bigcrimping/bhangmeterV3/assets/block-diagram-dark.png

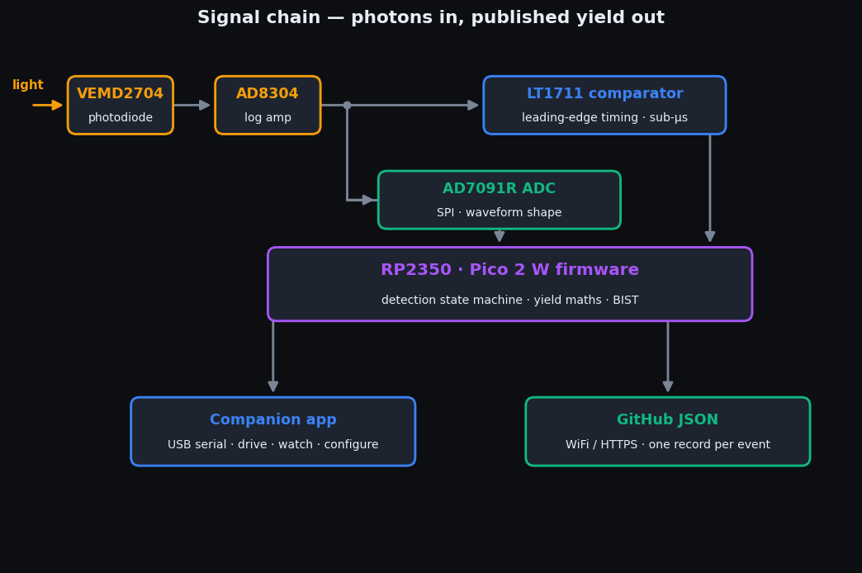
assets/block-diagram-dark.png
