bigcrimping/bhangmeterV3/assets/carrier-dark.png

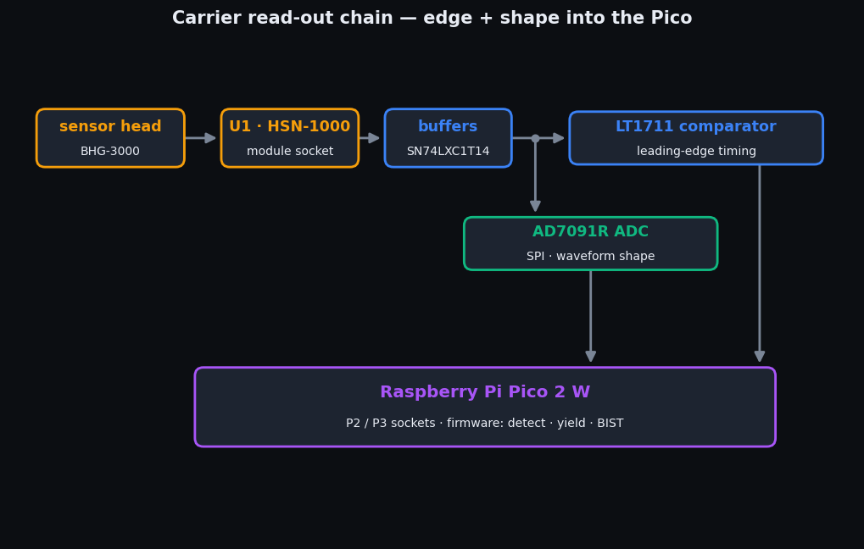
assets/carrier-dark.png
