bigcrimping/bhangmeterV3/assets/code-dataflow-dark.png

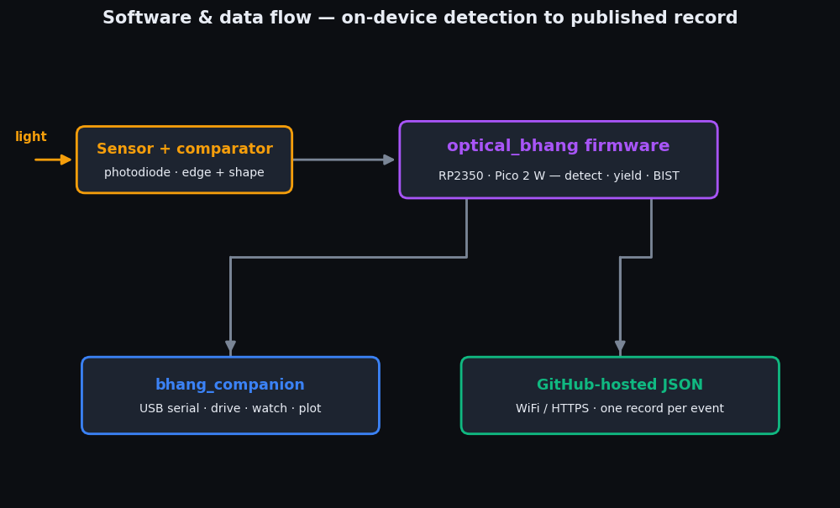
assets/code-dataflow-dark.png
