bigcrimping/bhangmeterV3/assets/double-pulse-annotated-dark.png

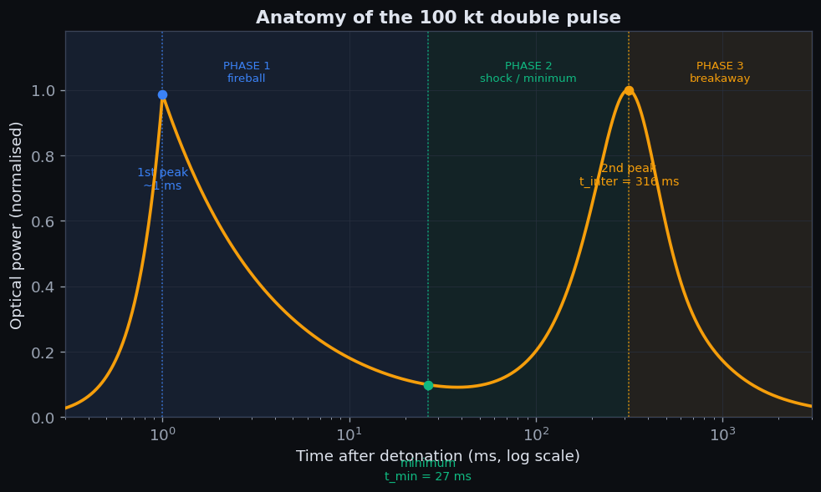
assets/double-pulse-annotated-dark.png
