bigcrimping/bhangmeterV3/assets/double-pulse-literature-dark.png

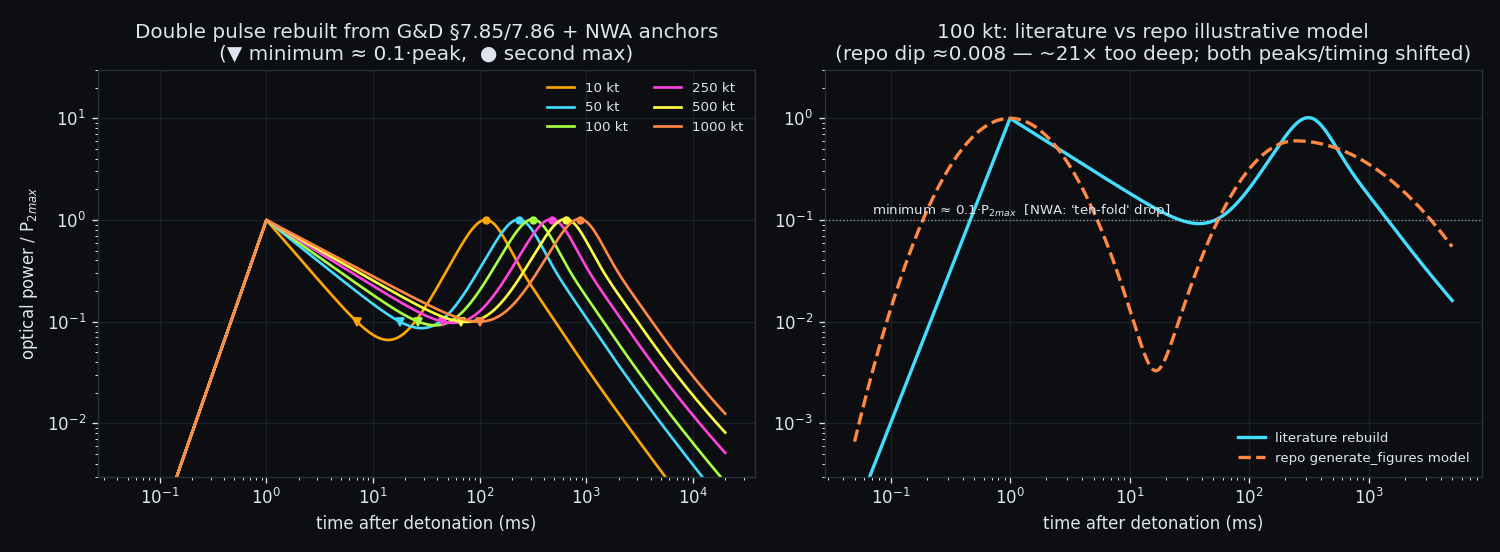
assets/double-pulse-literature-dark.png
