bigcrimping/bhangmeterV3/assets/double-pulse-literature-light.png

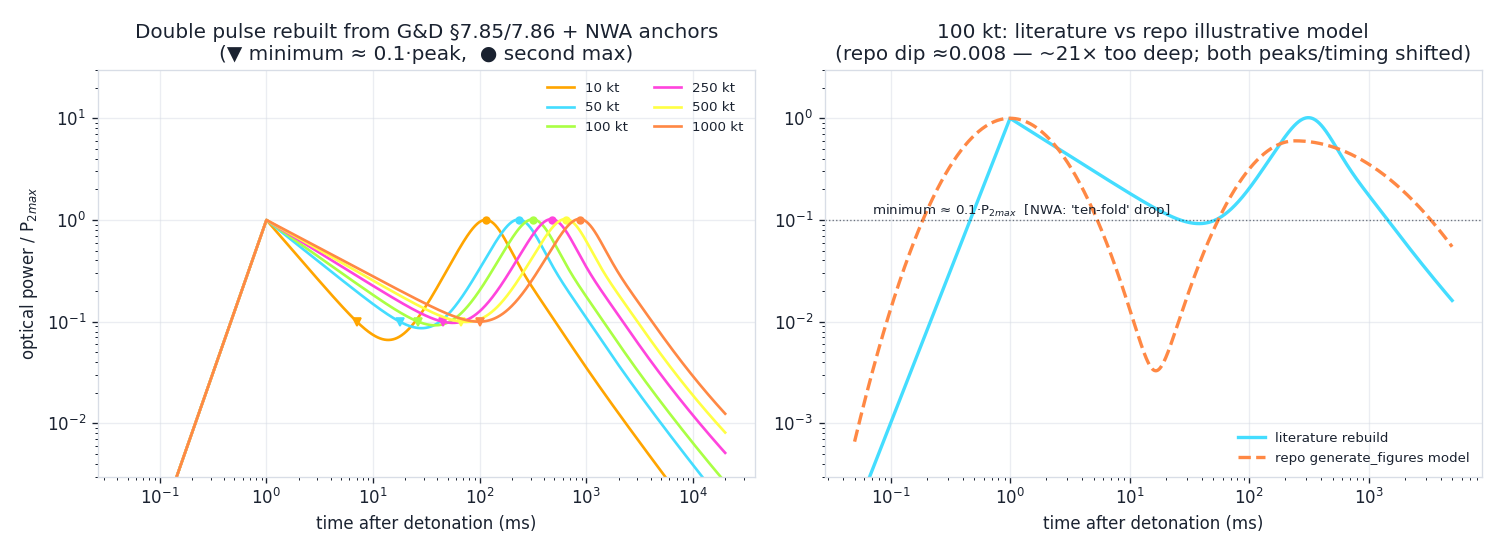
assets/double-pulse-literature-light.png
