bigcrimping/bhangmeterV3/assets/double-pulse-overlay-dark.png

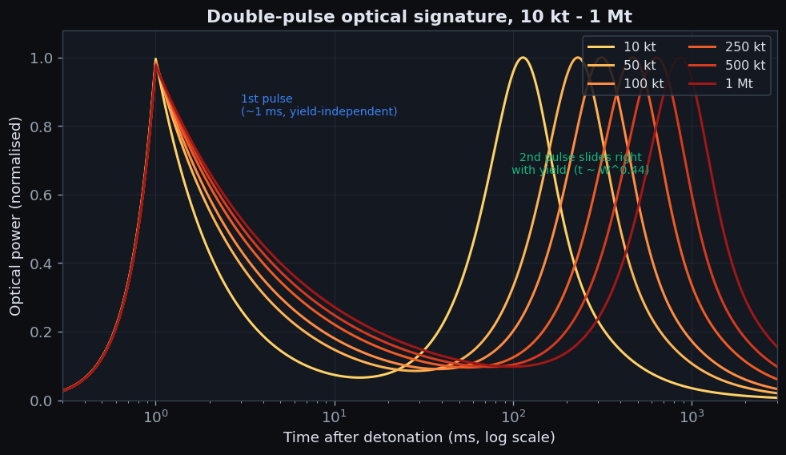
assets/double-pulse-overlay-dark.png
