bigcrimping/bhangmeterV3/assets/module.jpg

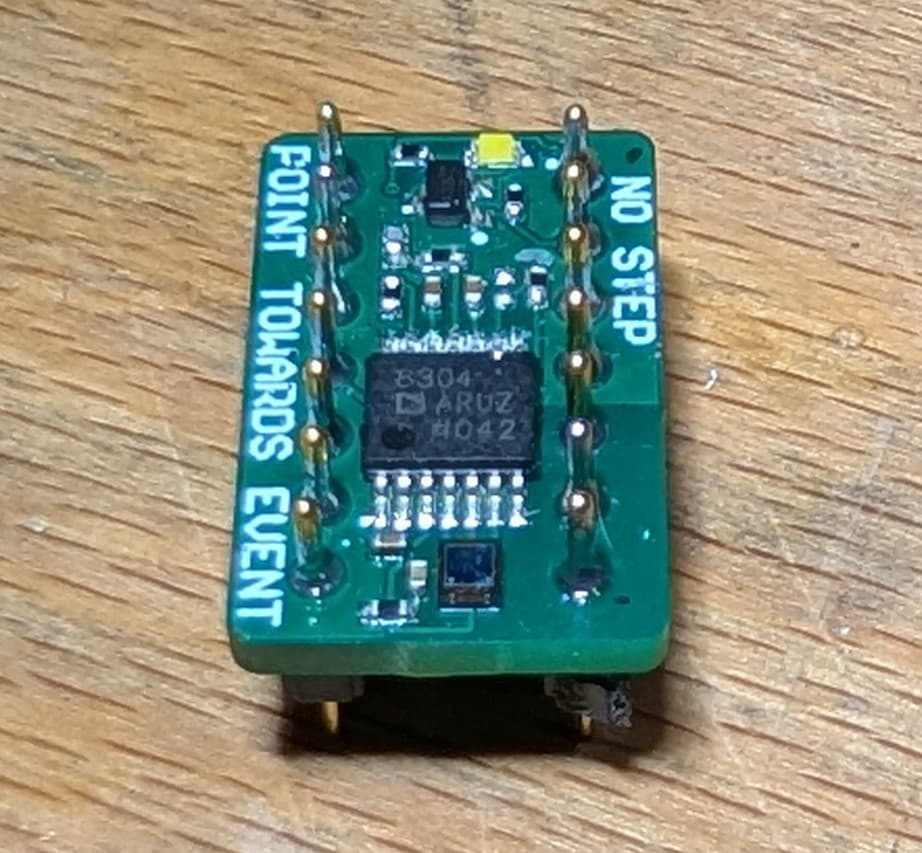
assets/module.jpg
