bigcrimping/bhangmeterV3/assets/pcb-boards-dark.png

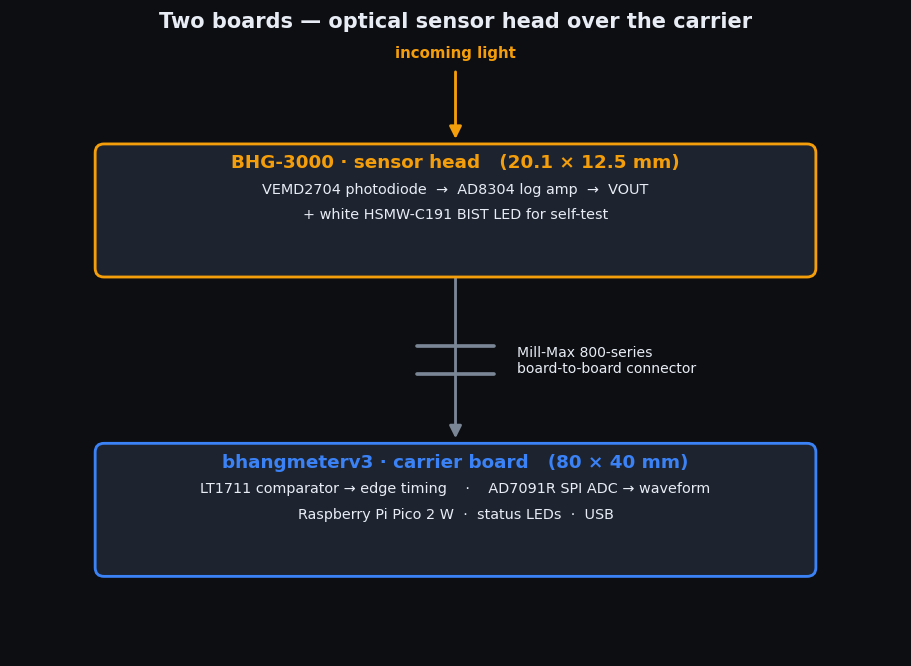
assets/pcb-boards-dark.png
