bigcrimping/bhangmeterV3/assets/photocurrent-vs-yield-dark.png

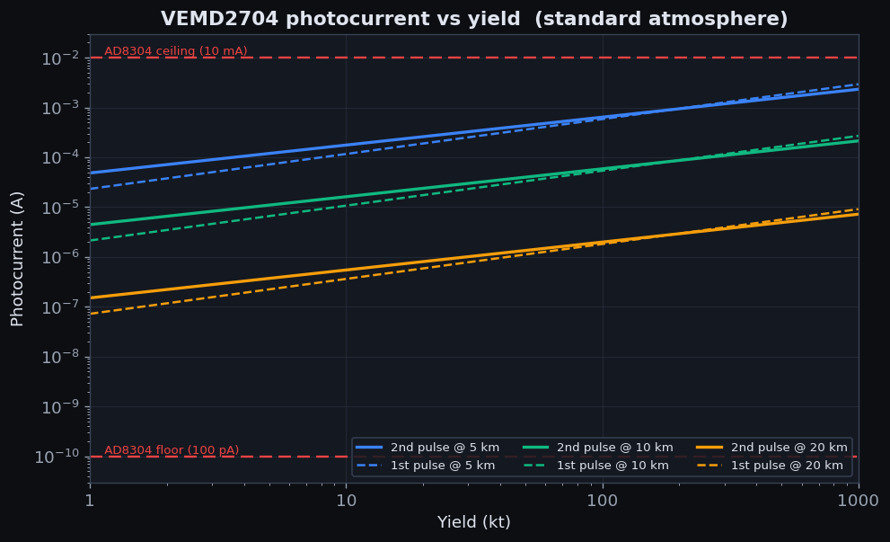
assets/photocurrent-vs-yield-dark.png
