bigcrimping/bhangmeterV3/assets/sensorhead-dark.png

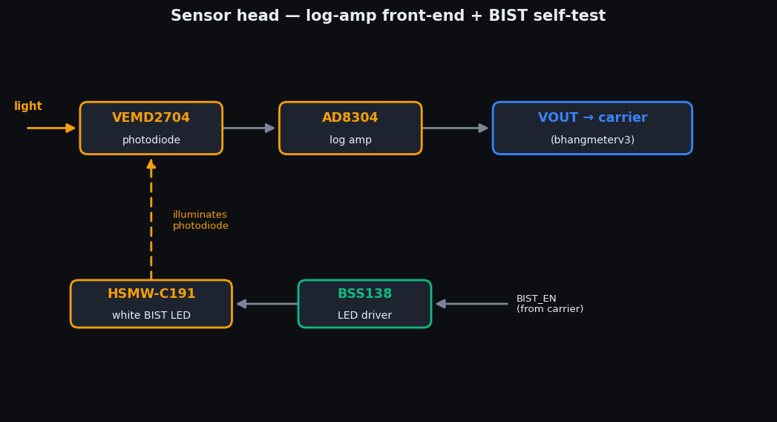
assets/sensorhead-dark.png
