bigcrimping/bhangmeterV3/assets/timing-vs-yield-dark.png

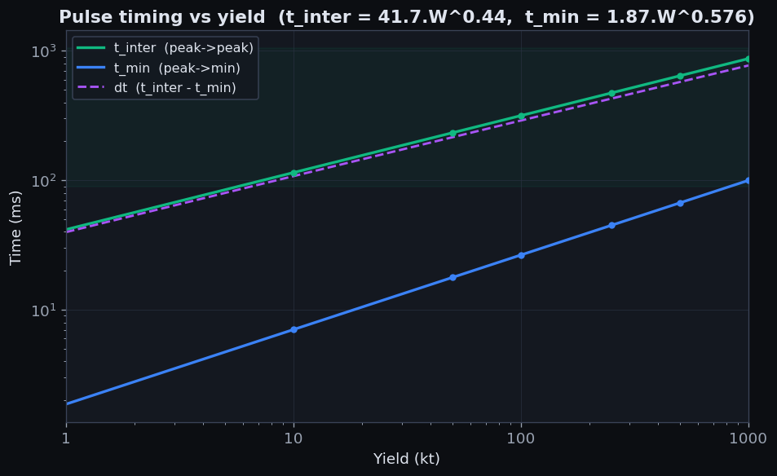
assets/timing-vs-yield-dark.png
