bigcrimping/bhangmeterV3/assets/timing-vs-yield-literature-dark.png

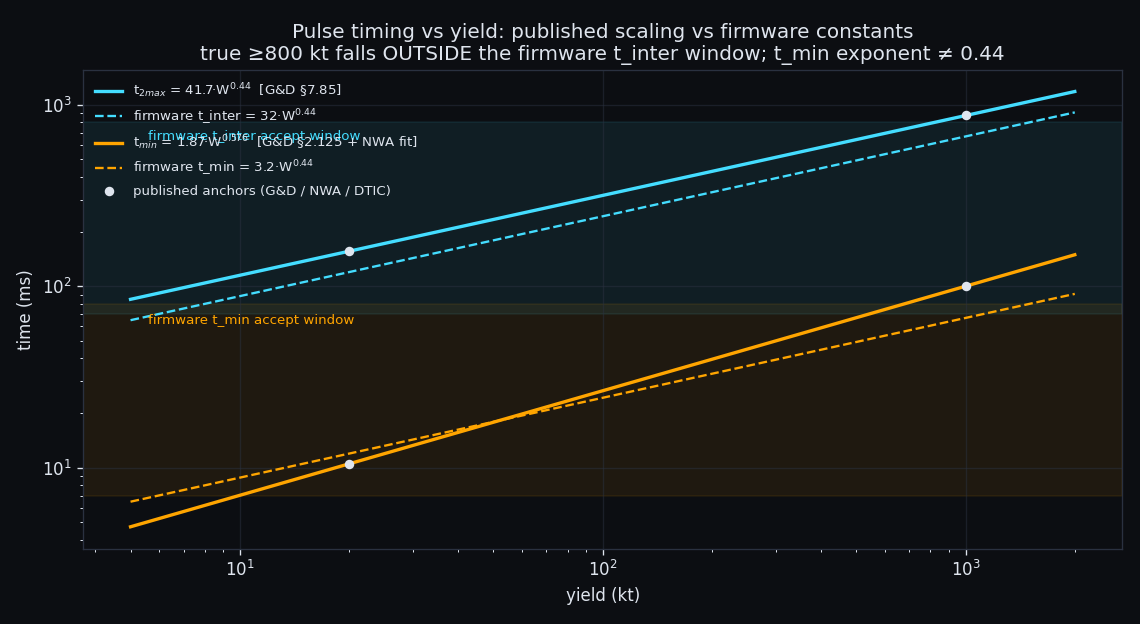
assets/timing-vs-yield-literature-dark.png
