bigcrimping/bhangmeterV3/assets/timing-vs-yield-literature-light.png

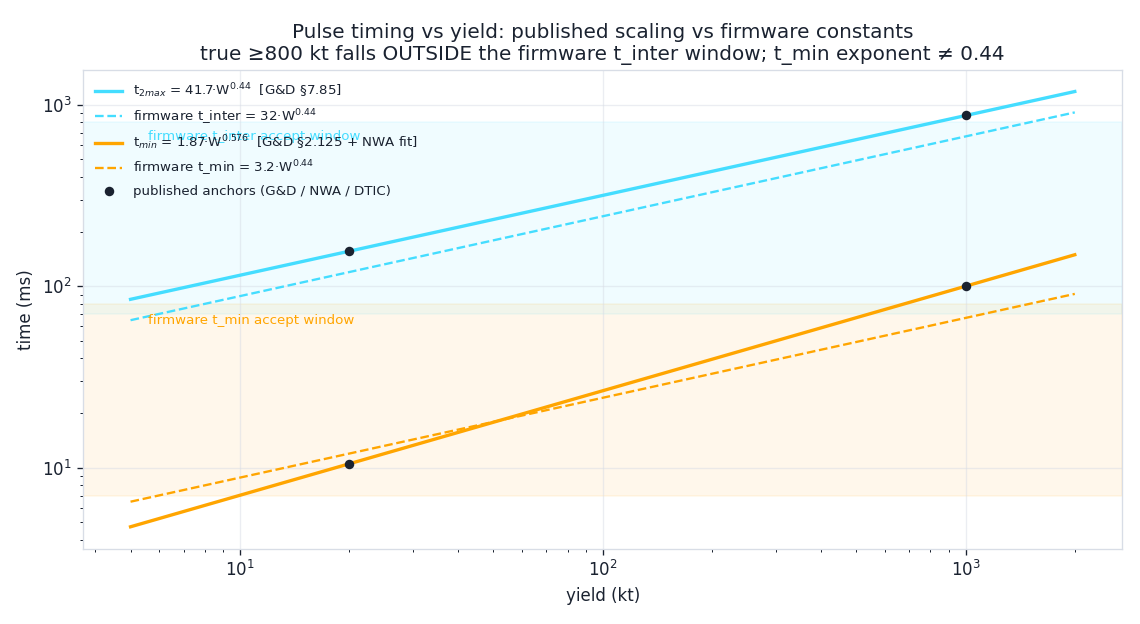
assets/timing-vs-yield-literature-light.png
