bigcrimping/bhangmeterV3/assets/vlog-vs-yield-dark.png

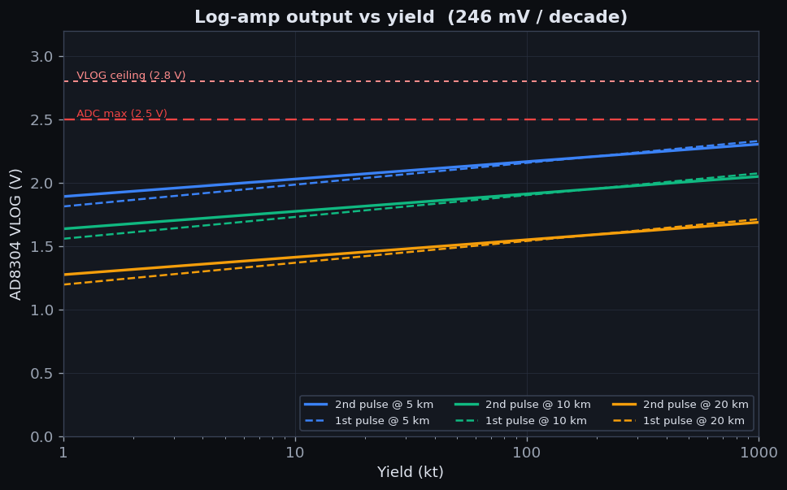
assets/vlog-vs-yield-dark.png
