bigcrimping/bhangmeterV3/assets/vlog-waveforms-dark.png

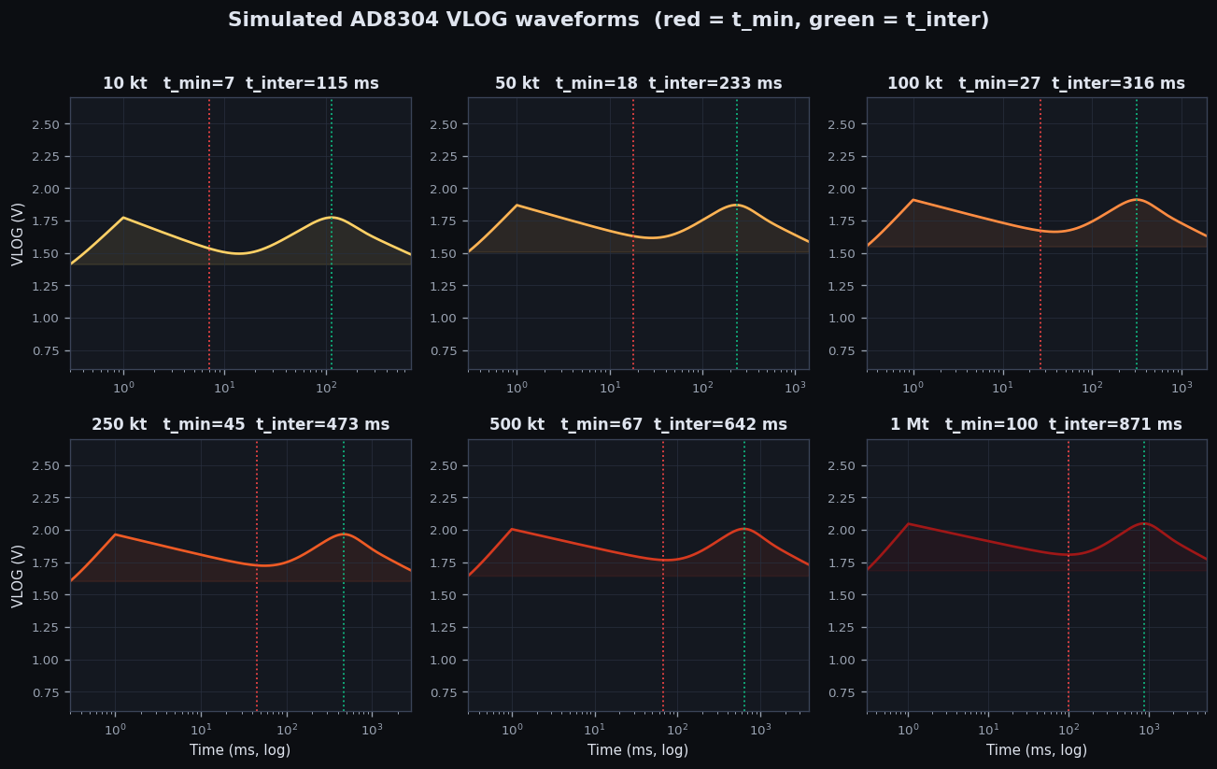
assets/vlog-waveforms-dark.png
