bigcrimping/bhangmeterV3/assets/vlog-waveforms-literature-dark.png

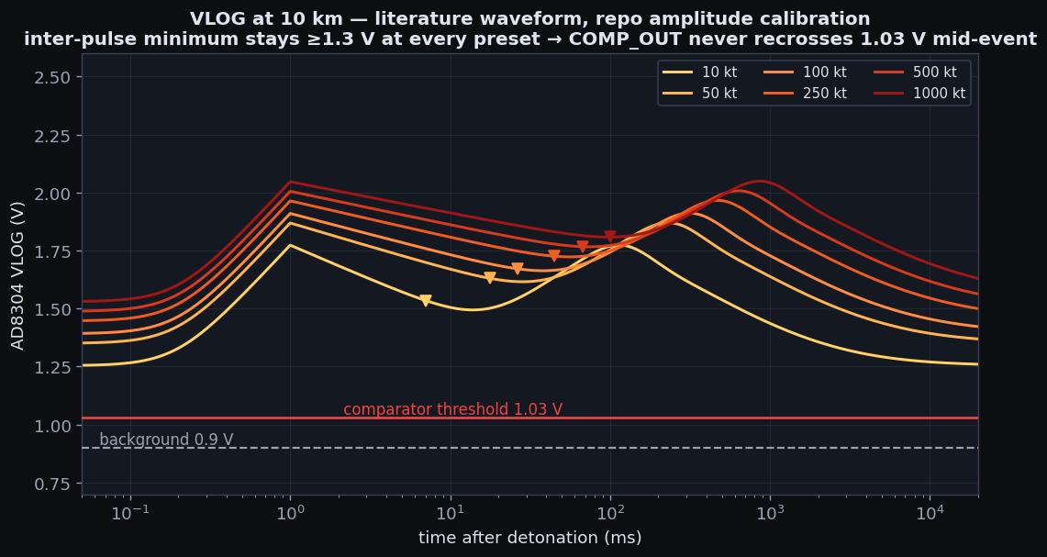
assets/vlog-waveforms-literature-dark.png
