bigcrimping/bhangmeterV3/assets/yield-from-tmin-dark.png

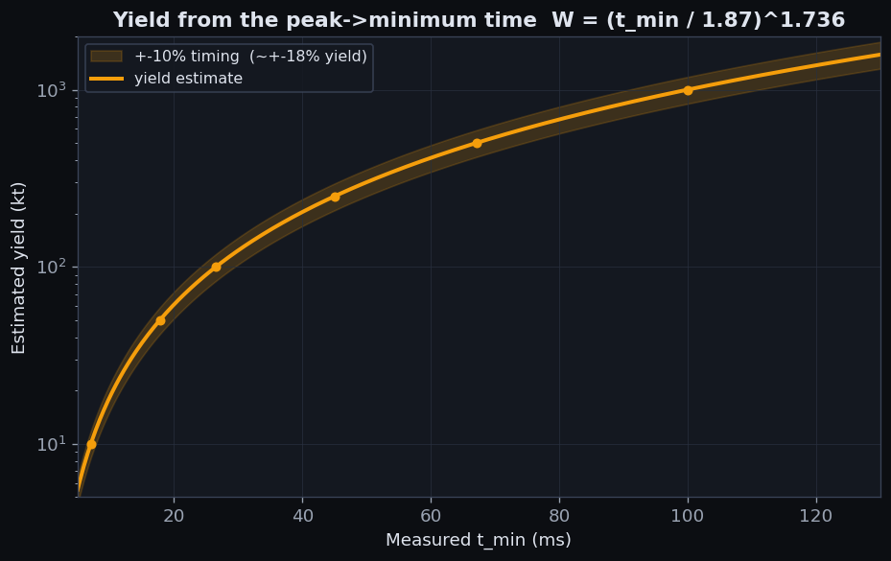
assets/yield-from-tmin-dark.png
