bigcrimping/bhangmeterV3/mech/plunger.3MF

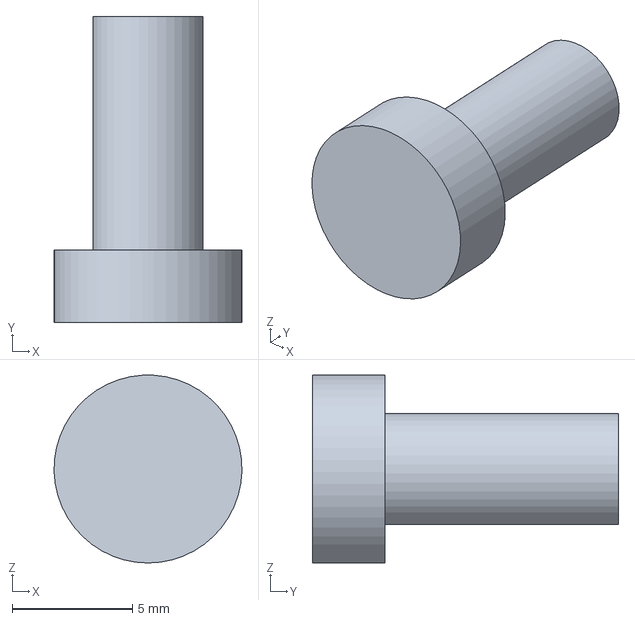
[picture p36: CAD file, 2026-06-13]
mech/plunger.3MF
7.80 x 12.7 x 7.80 mm
