bigcrimping/bhangmeterV3/mech/front.3mf

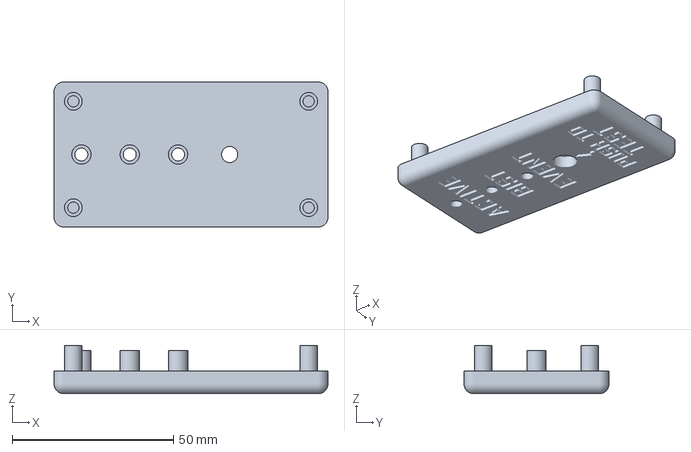
[picture p37: CAD file, 2026-06-13]
mech/front.3mf
85.0 x 45.0 x 15.0 mm
