bigcrimping/bhangmeterV3/mech/rear.3MF

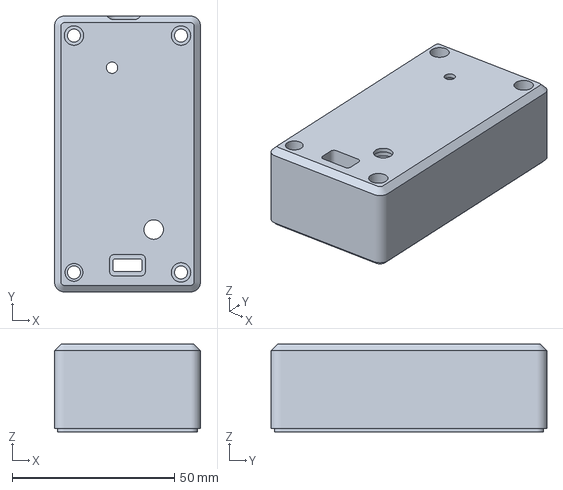
[picture p38: CAD file, 2026-06-13]
mech/rear.3MF
45.0 x 85.0 x 27.0 mm
