bigcrimping/bhangmeterV3/mech/washer.3MF

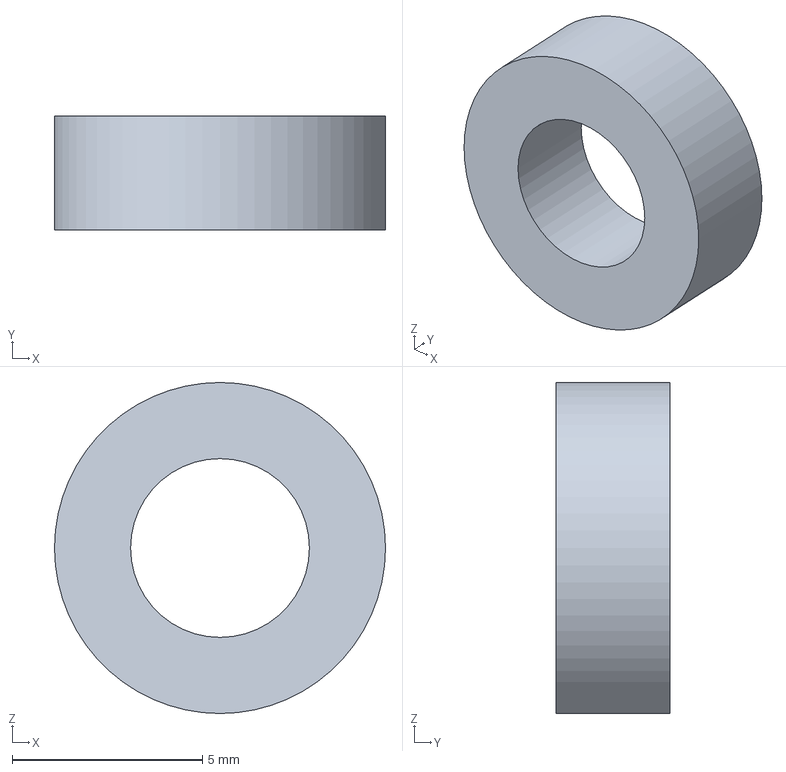
[picture p39: CAD file, 2026-06-13]
mech/washer.3MF
8.70 x 3.00 x 8.70 mm
