bigcrimping/bhangmeterV3/assets/test.png

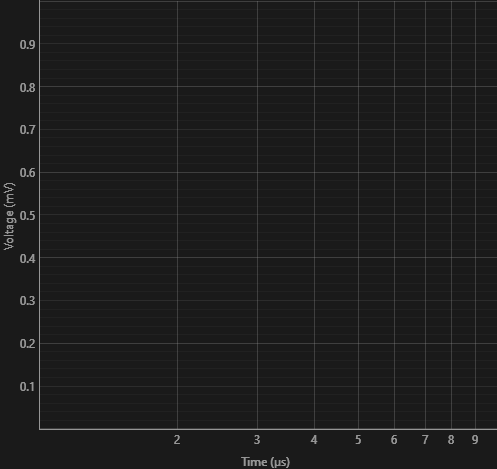
assets/test.png
