bigcrimping/bhangmeterV3/PCB/bhangmeterv3/Assembly.pdf

# R20R¹⁹ R¹³

U5

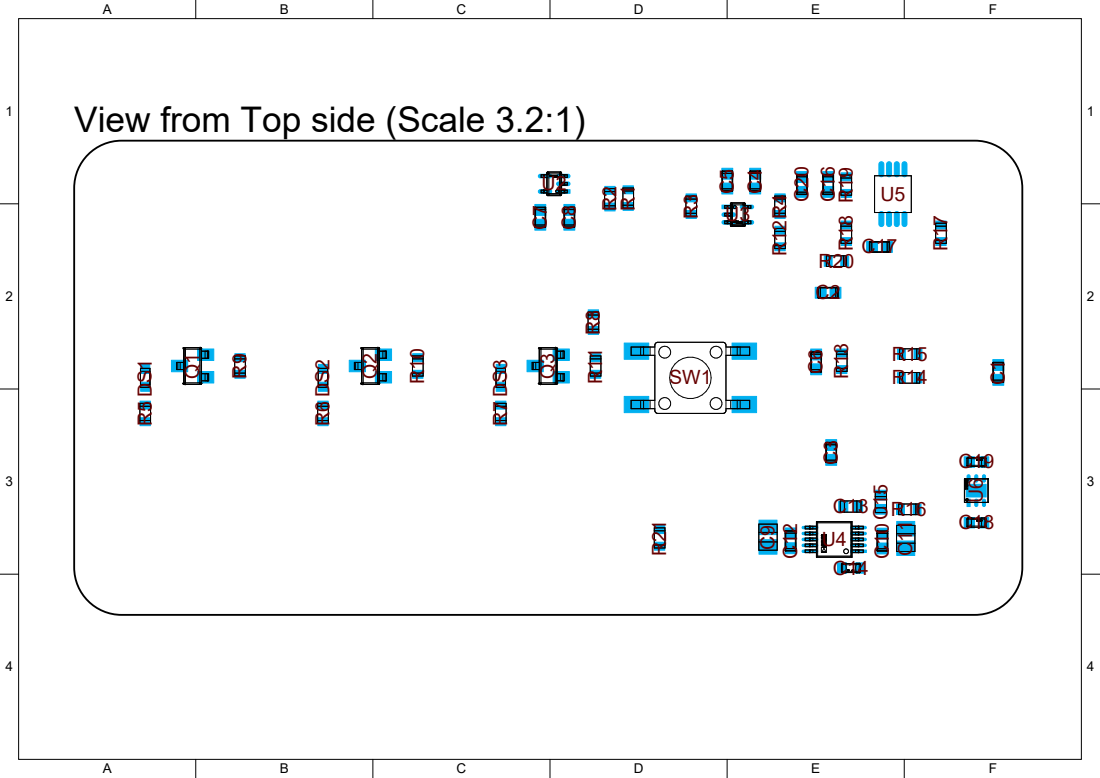
[picture p41: page 1]

View from Top side (Scale 3.2:1)

1 | 1

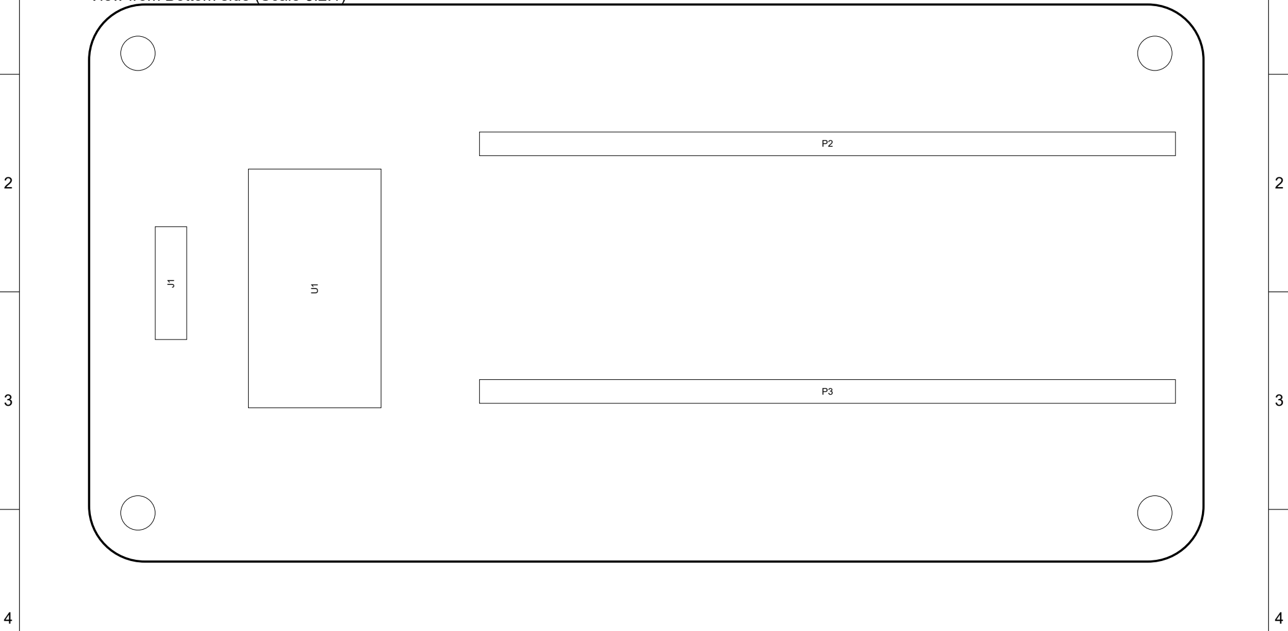
[picture p42: figure]
4 U¹J1

View from Bottom side (Scale 3.2:1)

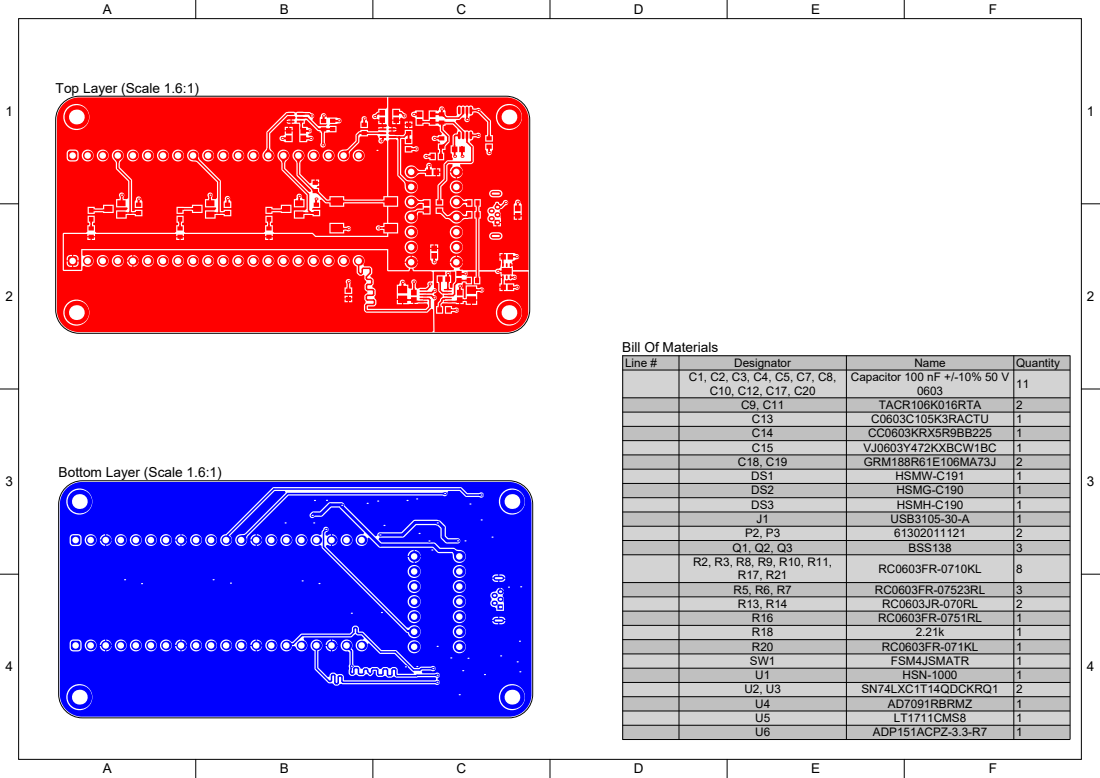
[picture p43: page 3]

Line # | Designator | Name | Quantity

C1, C2, C3, C4, C5, C7, C8, C10, C12, C17, C20 | Capacitor 100 nF +/-10% 50 V 0603 | 11

C9, C11 | TACR106K016RTA | 2
C13 | C0603C105K3RACTU | 1
C14 | CC0603KRX5R9BB225 | 1
C15 | VJ0603Y472KXBCW1BC | 1
C18, C19 | GRM188R61E106MA73J | 2
DS1 | HSMW-C191 | 1
DS2 | HSMG-C190 | 1
DS3 | HSMH-C190 | 1
J1 | USB3105-30-A | 1
P2, P3 | 61302011121 | 2
Q1, Q2, Q3 | BSS138 | 3

R5, R6, R7 | RC0603FR-07523RL | 3
R13, R14 | RC0603JR-070RL | 2
R16 | RC0603FR-0751RL | 1
R18 | 2.21k | 1
R20 | RC0603FR-071KL | 1
SW1 | FSM4JSMATR | 1
U1 | HSN-1000 | 1
U2, U3 | SN74LXC1T14QDCKRQ1 | 2
U4 | AD7091RBRMZ | 1
U5 | LT1711CMS8 | 1
U6 | ADP151ACPZ-3.3-R7 | 1
