bigcrimping/bhangmeterV3/PCB/bhangmeterv3/Schematic.pdf

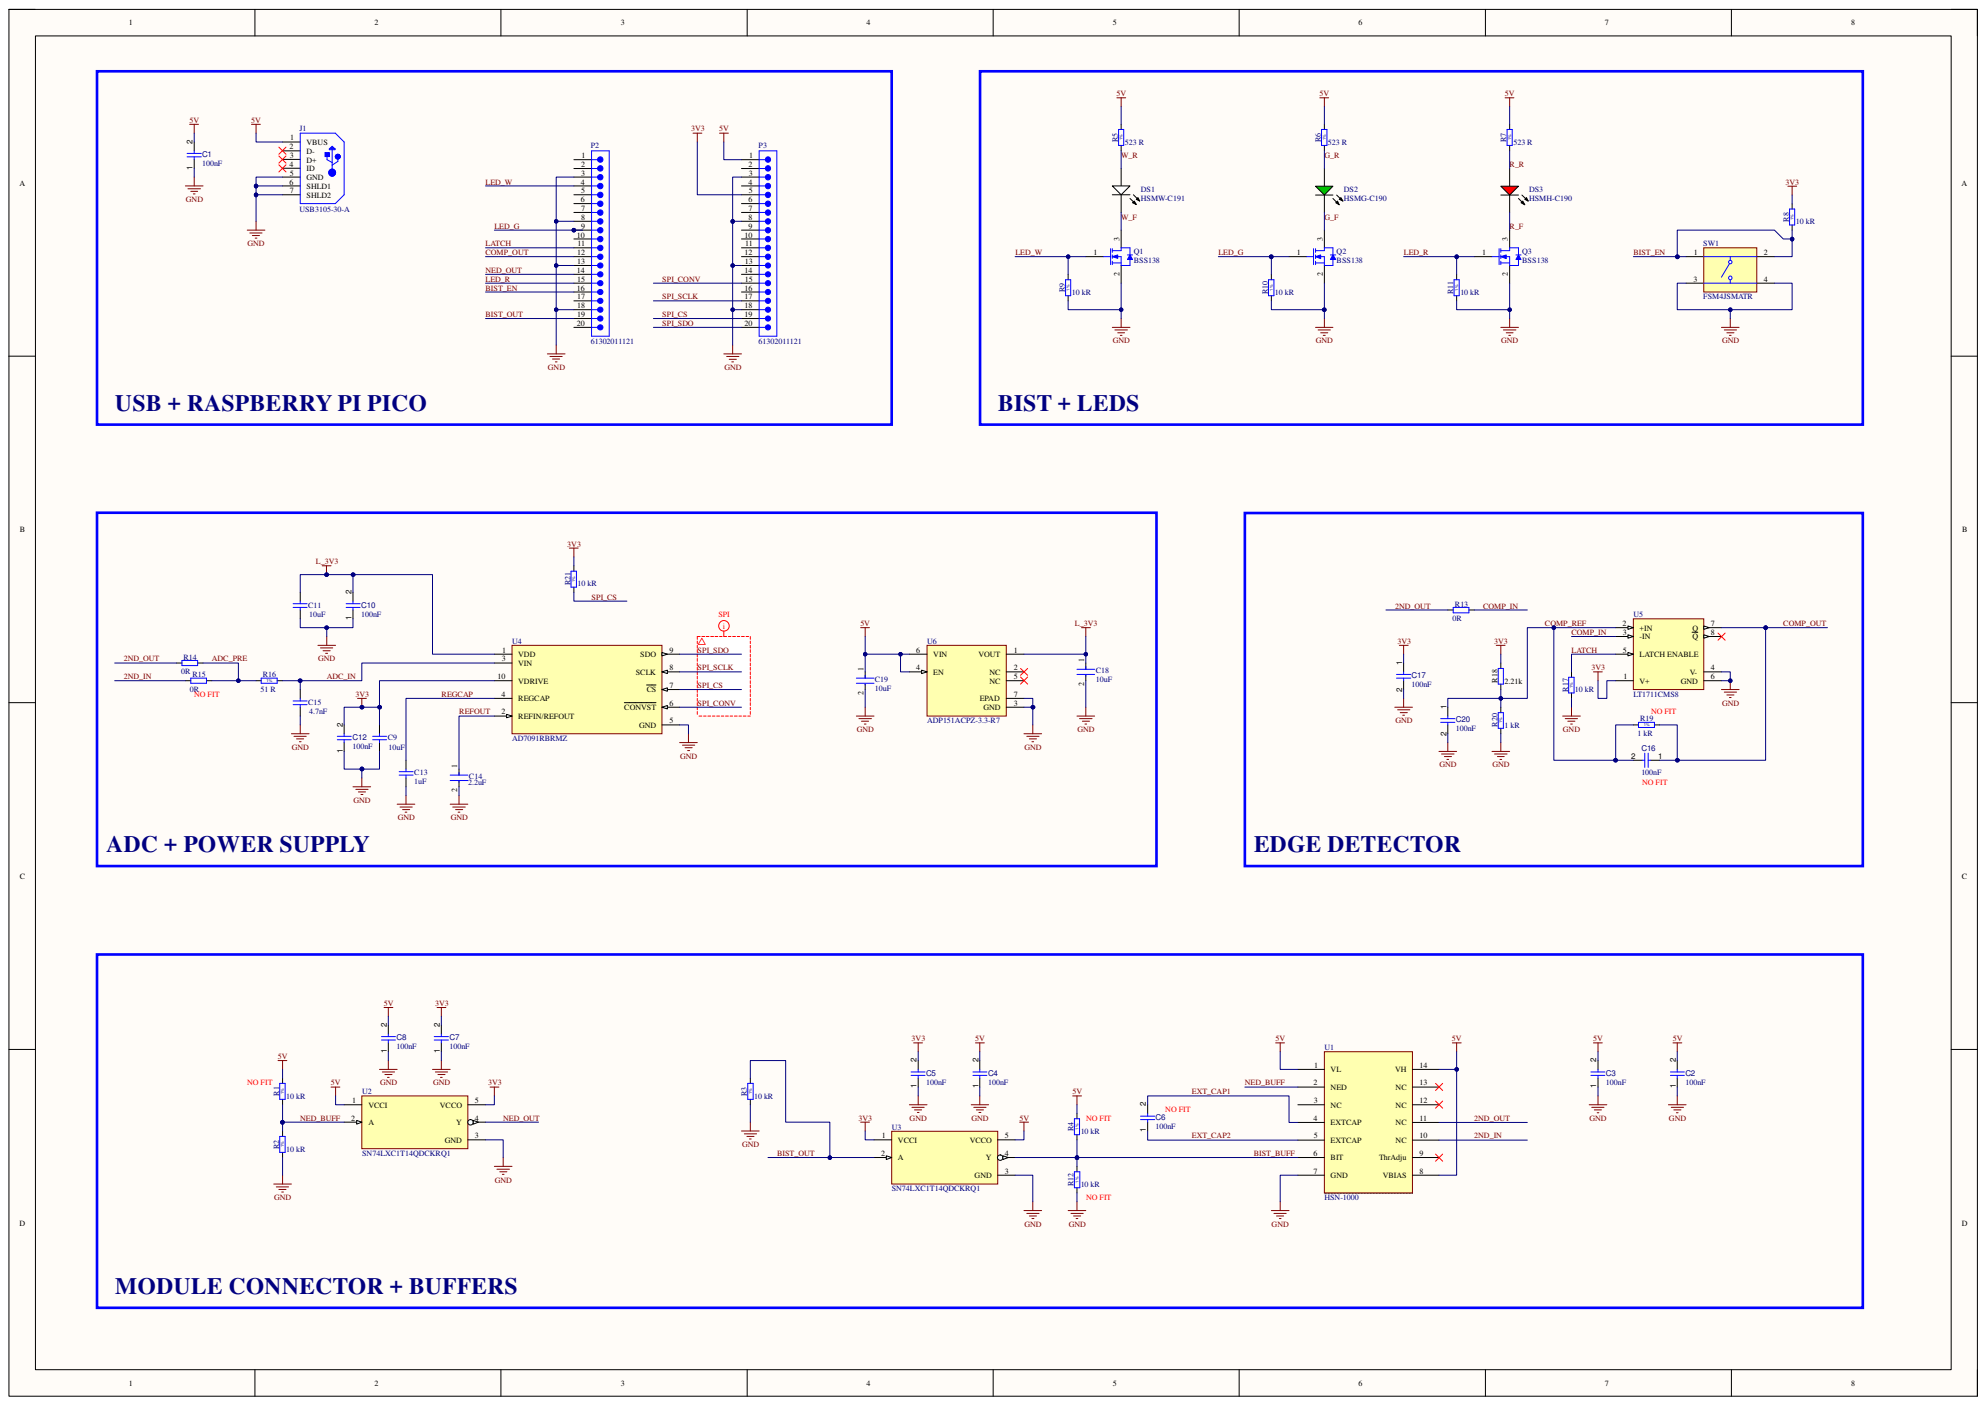
[picture p44: page 1]
