bigcrimping/bhangmeterV3/PCB/BHG-3000/ASY.pdf

# View from Top side (Scale 12:1)

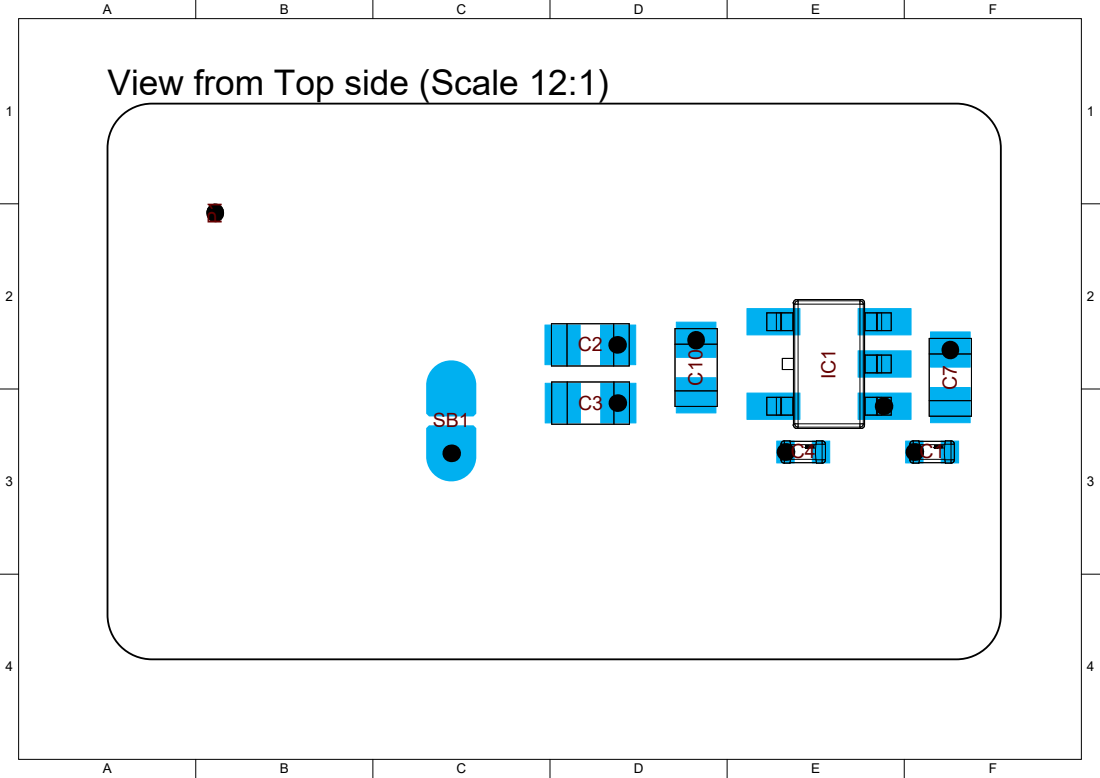
[picture p45: page 1]

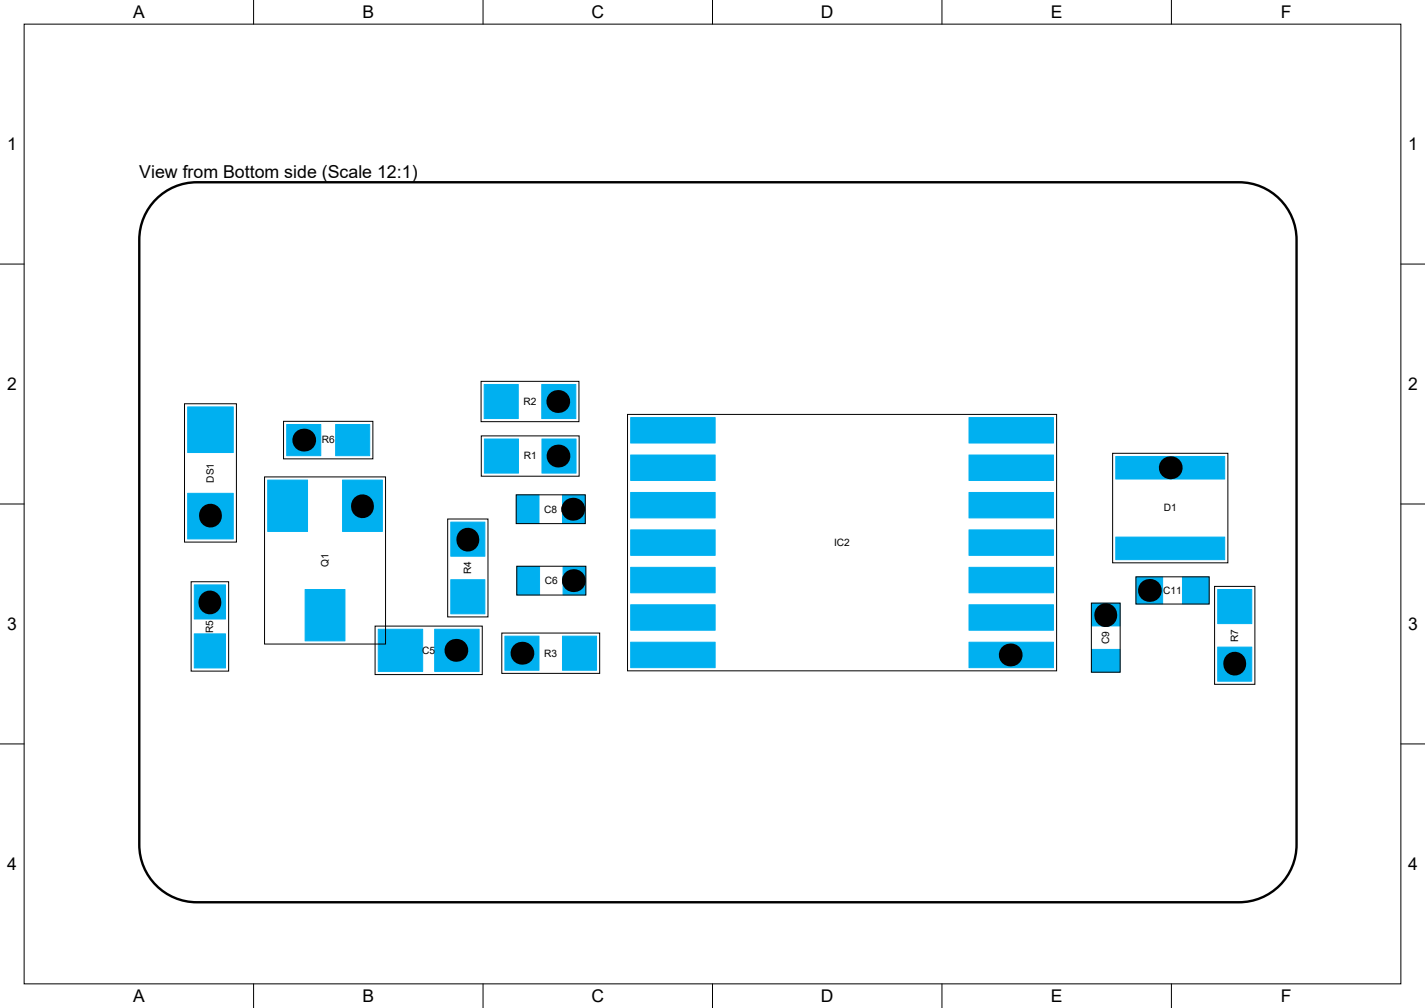
[picture p46: page 2]

View from Bottom side (Scale 12:1)

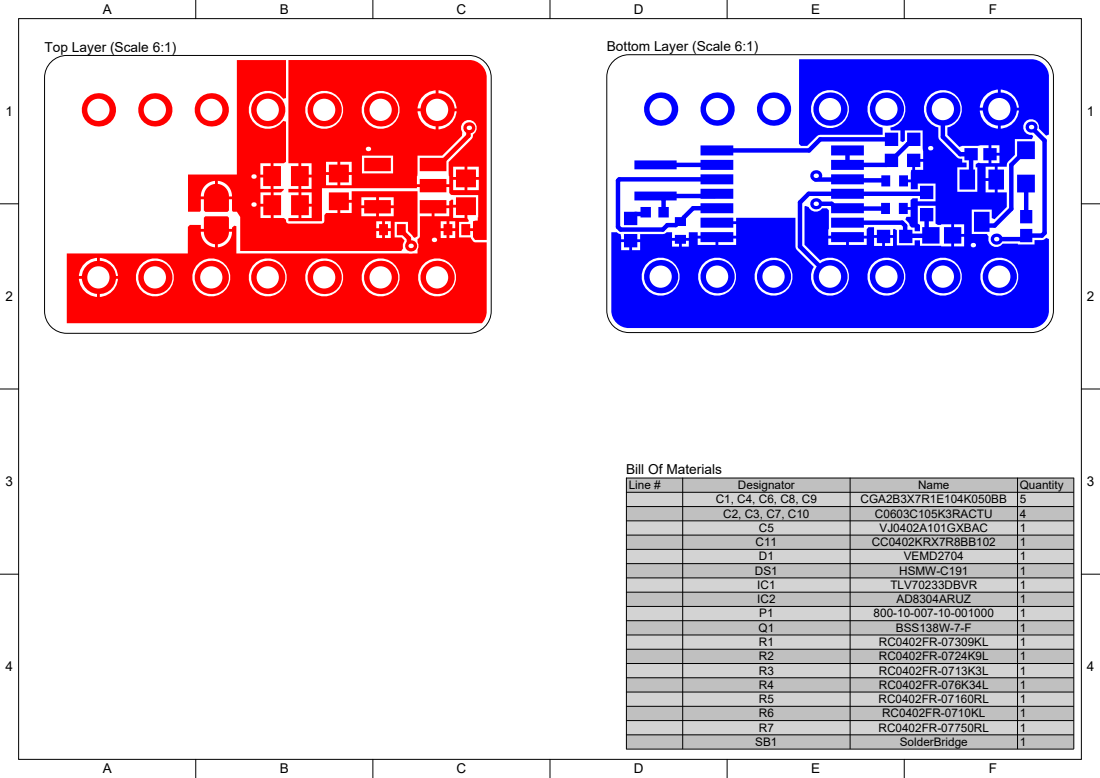
[picture p47: page 3]

Line # | Designator | Name | Quantity

C1, C4, C6, C8, C9 | CGA2B3X7R1E104K050BB | 5
C2, C3, C7, C10 | C0603C105K3RACTU | 4
C5 | VJ0402A101GXBAC | 1
C11 | CC0402KRX7R8BB102 | 1
D1 | VEMD2704 | 1
DS1 | HSMW-C191 | 1
IC1 | TLV70233DBVR | 1
IC2 | AD8304ARUZ | 1
P1 | 800-10-007-10-001000 | 1
Q1 | BSS138W-7-F | 1
R1 | RC0402FR-07309KL | 1
R2 | RC0402FR-0724K9L | 1
R3 | RC0402FR-0713K3L | 1
R4 | RC0402FR-076K34L | 1
R5 | RC0402FR-07160RL | 1
R6 | RC0402FR-0710KL | 1
R7 | RC0402FR-07750RL | 1
SB1 | SolderBridge | 1
