bigcrimping/bhangmeterV3/PCB/BHG-3000/SCHEM.pdf

# CONNECT

O

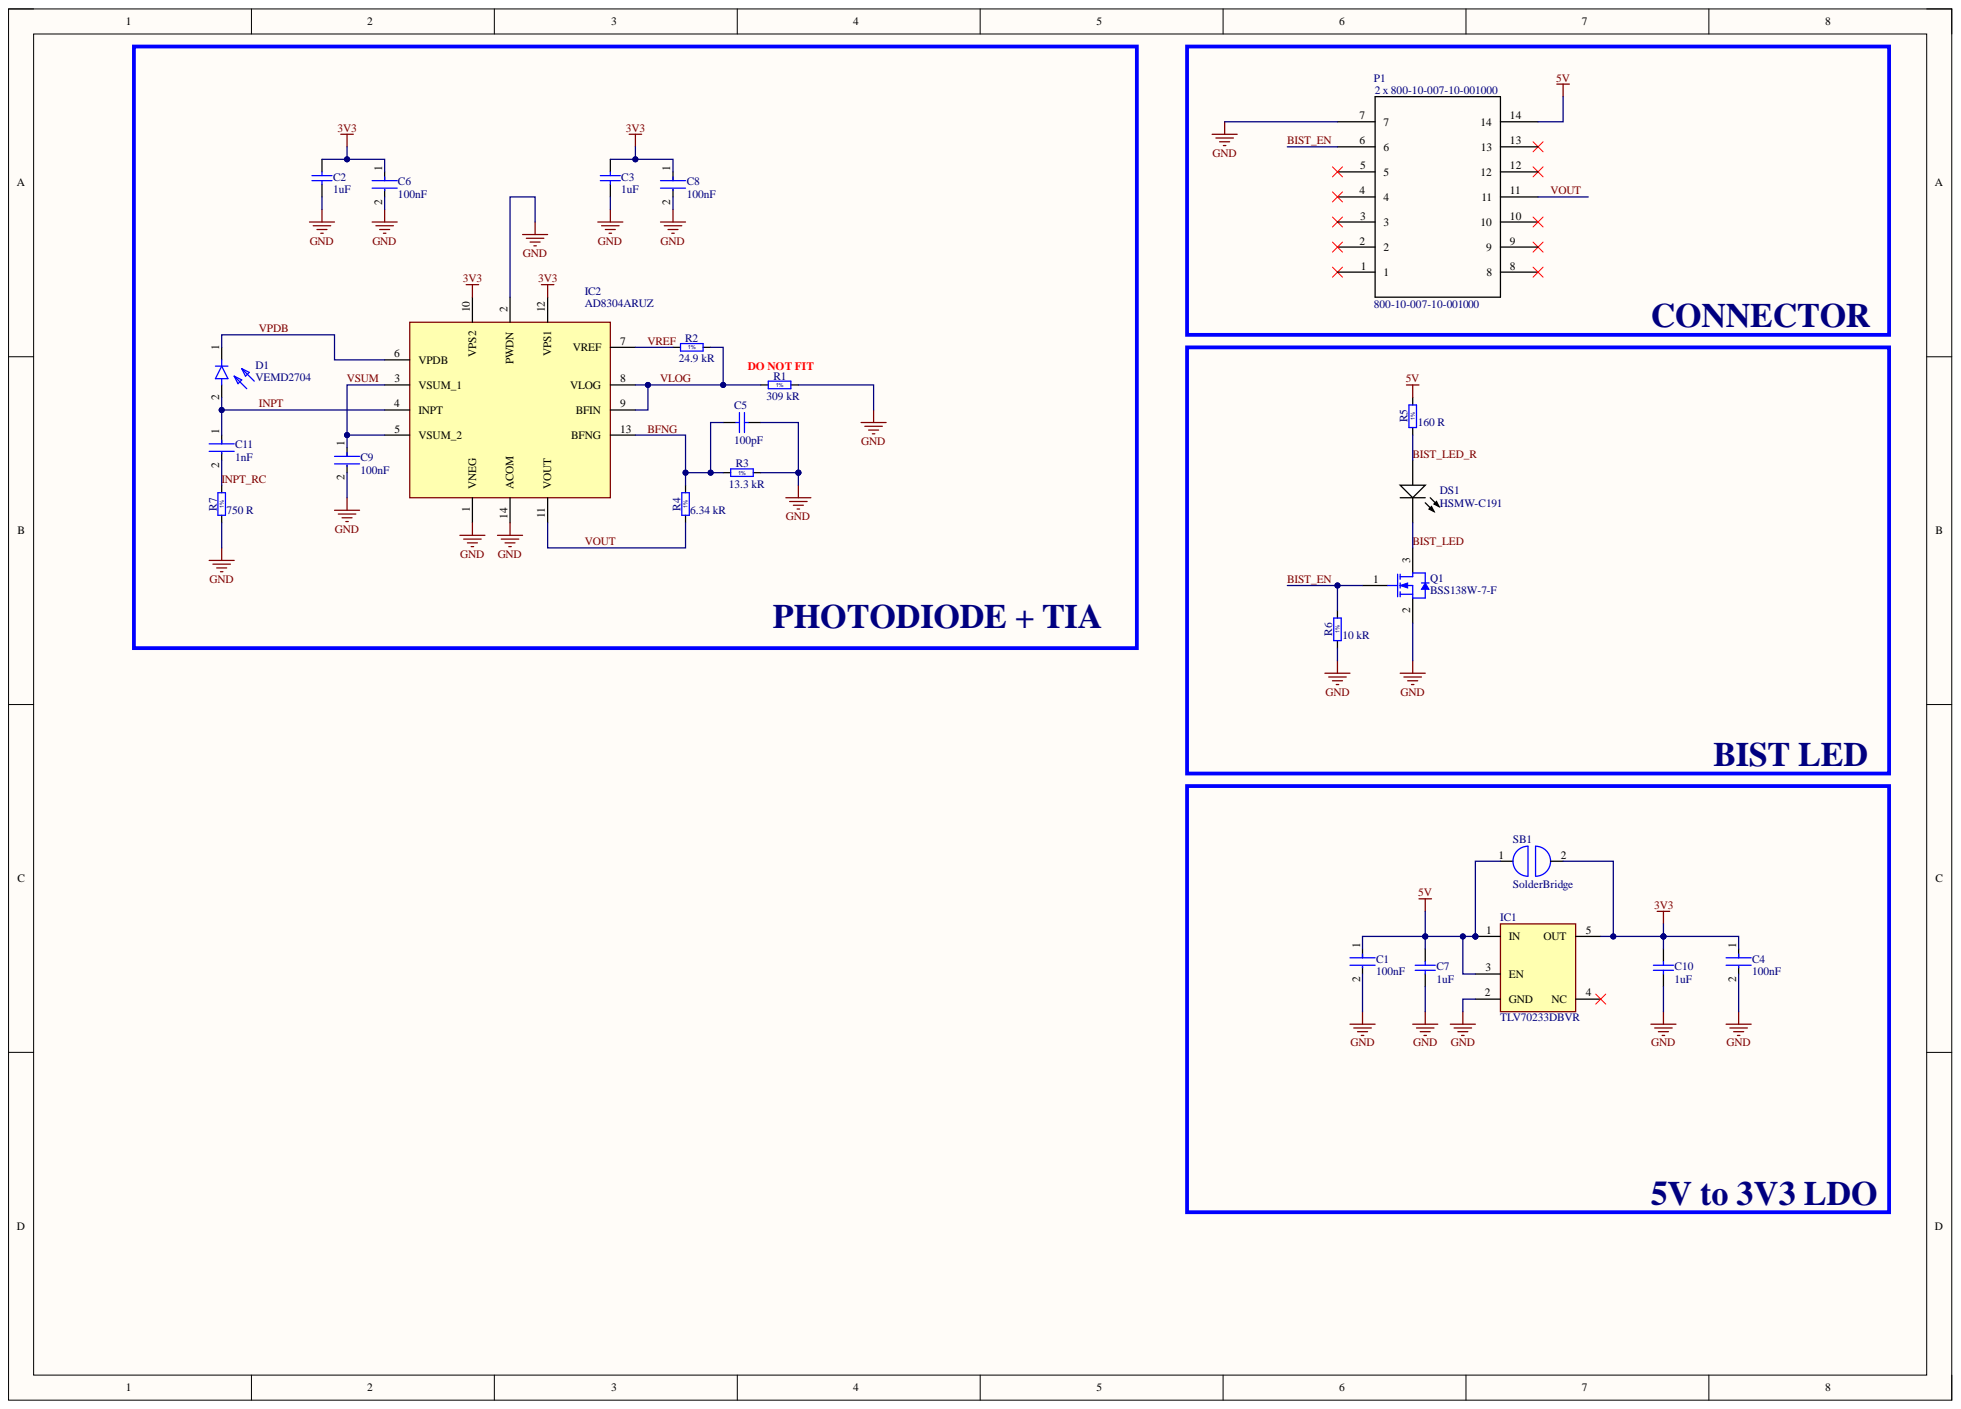
[picture p48: page 1]

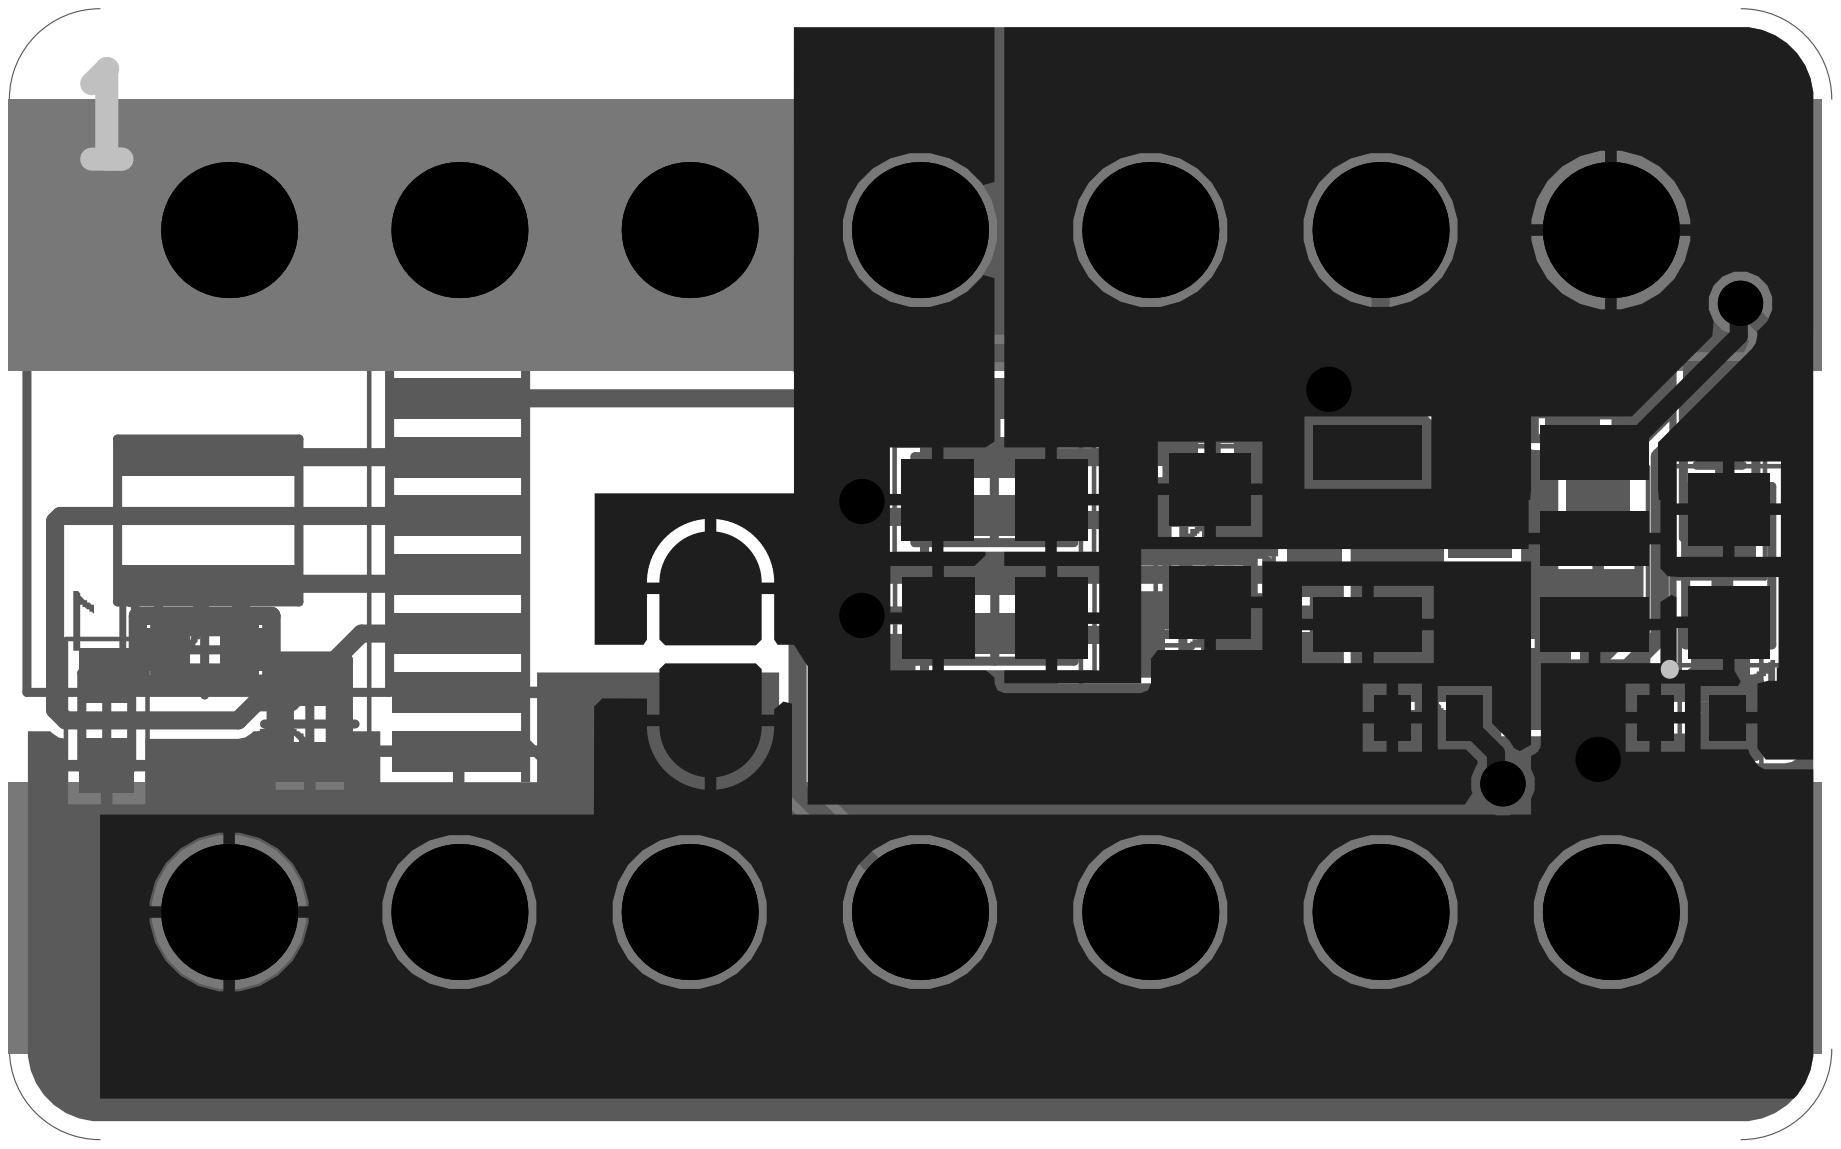
[picture p49: page 2]
